Eduardo-Barreto/Bateria-Musical-Eletronica/(commit log)

2021-11-27 ADICIONADO: Testes de piezo
2021-11-27 REMOVIDO/MODIFICADO: Vídeo de demonstração teste piezo 1
2021-11-27 MODIFICADO: Vídeo no readme e link de acesso ao diagrama de teste 2
2021-11-29 ADICIONADO: Configurações para outros jogos
2022-01-29 CORRIGIDO: Link para escolha dos materiais
2022-01-29 ALTERADO: Arduino centralizado e ênfases
2022-01-30 ADICIONADO: Vídeo de demonstração
